ryanforsberg/me507/README.md

# me507
Cal Poly ME 507 Sumo Bot Project

The latest code is located in /Code/Sumo_RTOS/
