ryanforsberg/me507/EAGLE/Schematic/fullboard.brd

## EAGLE design EAGLE/Schematic/fullboard.brd (2019-10-31)

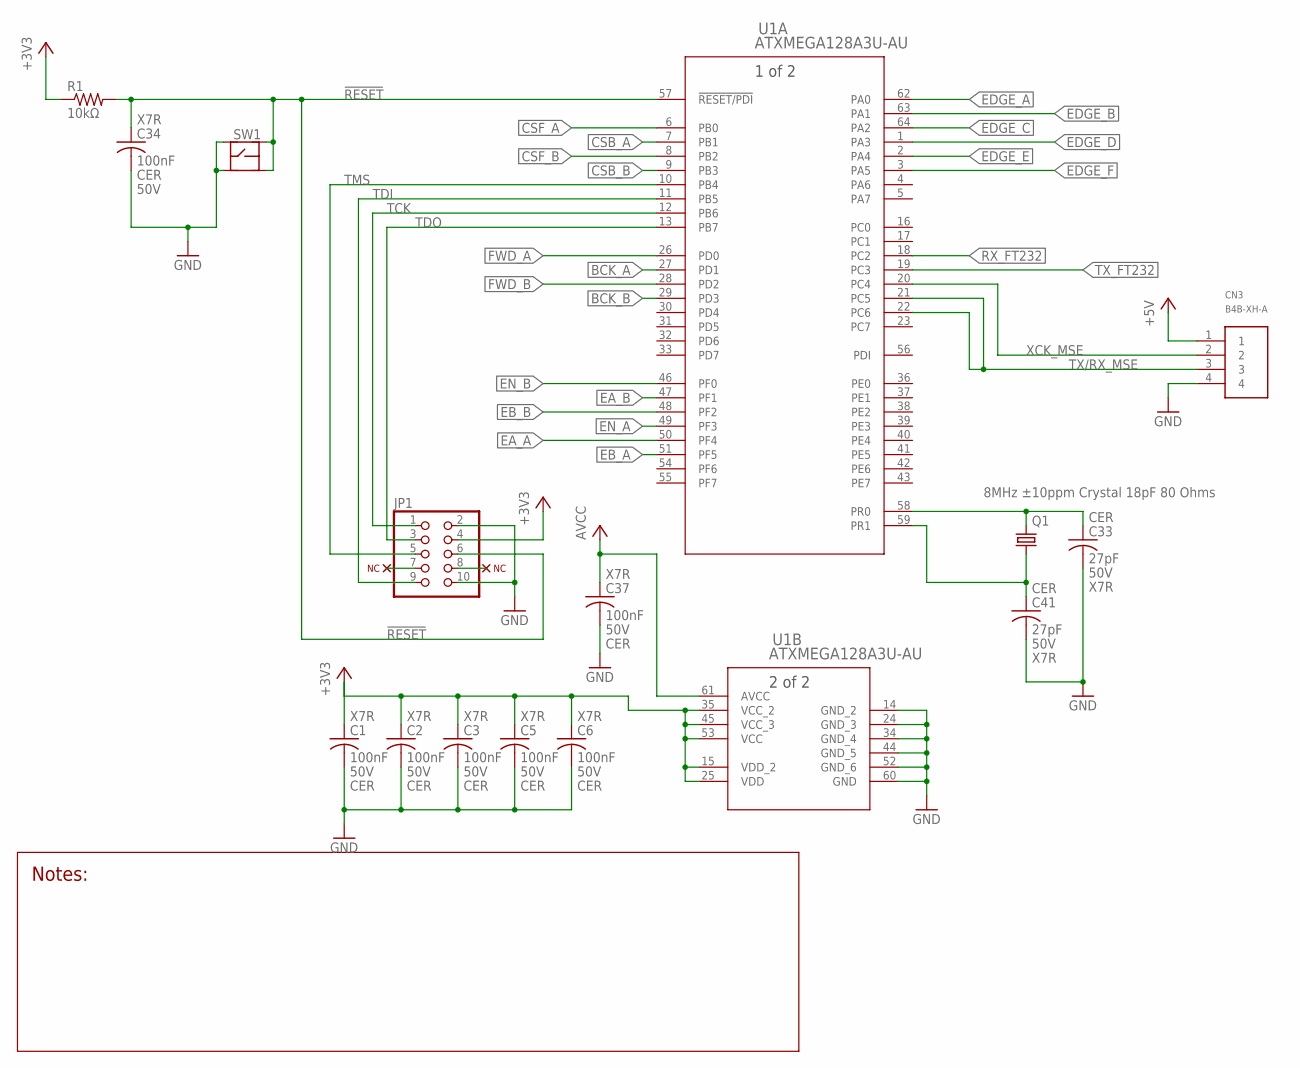
[picture p1: schematic fullboard.sch, sheet 1, MCU]

Parts:
C1, C2, C3, C5, C6, C34, C37: 100nF; C0805
C33, C41: 27pF; C0805
CN3: B4B-XH-A
JP1: PINHD-2X5; 2X05
Q1: 8MHz ±10ppm Crystal 18pF 80 Ohms; HC49UP
R1: 10kΩ; R0805
SW1: TR1-SPST; TR1
U1: ATXMEGA128A3U-AU; 64A

Connections:
!RESET: C34.1, JP1.6, R1.2, SW1.3, SW1.4, U1.57 (!RESET/PDI)
+3V3: C1.1, C2.1, C3.1, C5.1, C6.1, JP1.4, R1.1, U1.15 (VDD_2), U1.25 (VDD), U1.35 (VCC_2), U1.45 (VCC_3), U1.53 (VCC); also elsewhere on the board
+5V: CN3.1; also elsewhere on the board
AVCC: C37.1, U1.61 (AVCC); also elsewhere on the board
BCK_A: U1.27 (PD1); also elsewhere on the board
BCK_B: U1.29 (PD3); also elsewhere on the board
CSB_A: U1.7 (PB1)
CSB_B: U1.9 (PB3)
CSF_A: U1.6 (PB0)
CSF_B: U1.8 (PB2)
EA_A: U1.50 (PF4); also elsewhere on the board
EA_B: U1.47 (PF1); also elsewhere on the board
EB_A: U1.51 (PF5); also elsewhere on the board
EB_B: U1.48 (PF2); also elsewhere on the board
EDGE_A: U1.62 (PA0)
EDGE_B: U1.63 (PA1)
EDGE_C: U1.64 (PA2)
EDGE_D: U1.1 (PA3)
EDGE_E: U1.2 (PA4)
EDGE_F: U1.3 (PA5)
EN_A: U1.49 (PF3); also elsewhere on the board
EN_B: U1.46 (PF0); also elsewhere on the board
FWD_A: U1.26 (PD0); also elsewhere on the board
FWD_B: U1.28 (PD2); also elsewhere on the board
GND: C1.2, C2.2, C3.2, C5.2, C6.2, C33.2, C34.2, C37.2, C41.2, CN3.4, JP1.2, JP1.10, SW1.1, SW1.2, U1.14 (GND_2), U1.24 (GND_3), U1.34 (GND_4), U1.44 (GND_5), U1.52 (GND_6), U1.60 (GND); also elsewhere on the board
RX_FT232: U1.18 (PC2); also elsewhere on the board
TCK: JP1.1, U1.12 (PB6)
TDI: JP1.9, U1.11 (PB5)
TDO: JP1.3, U1.13 (PB7)
TMS: JP1.5, U1.10 (PB4)
TX/RX_MSE: CN3.3, U1.21 (PC5), U1.22 (PC6)
TX_FT232: U1.19 (PC3); also elsewhere on the board
XCK_MSE: CN3.2, U1.20 (PC4)
XTAL1: C41.1, Q1.2, U1.59 (PR1)
XTAL2: C33.1, Q1.1, U1.58 (PR0)

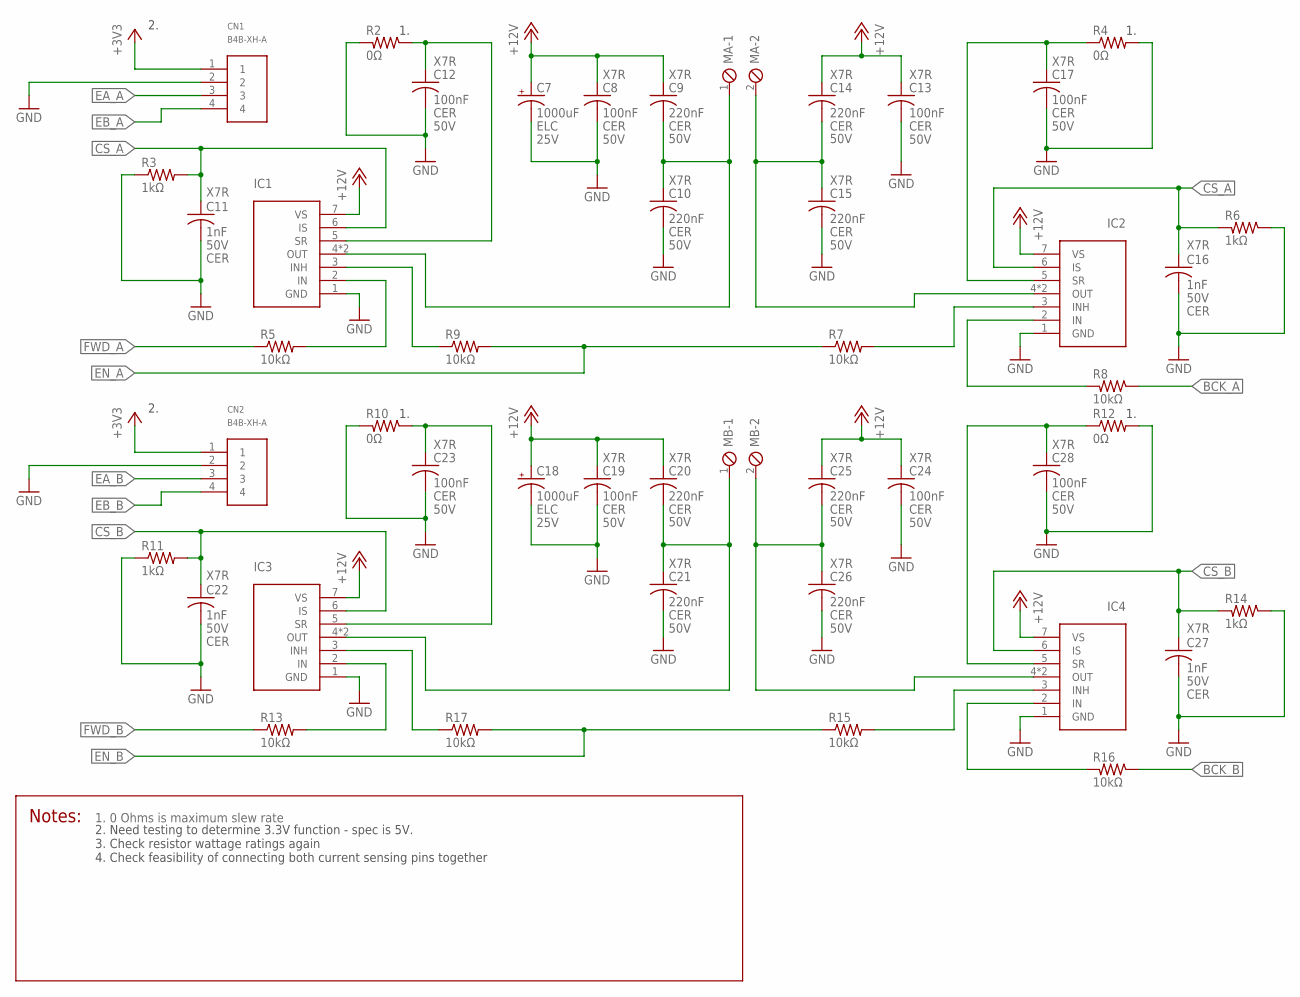
[picture p2: schematic fullboard.sch, sheet 2, Motor drivers]

Parts:
C7, C18: 1000uF; E5-10
C8, C12, C13, C17, C19, C23, C24, C28: 100nF; C0805
C9, C10, C14, C15, C20, C21, C25, C26: 220nF; C0805
C11, C16, C22, C27: 1nF; C0805
CN1, CN2: B4B-XH-A
IC1, IC2, IC3, IC4: IFX007T; TO127P1500X440-7N
MA: SCREWTERM_2P_508; 2POL508
MB: SCREWTERM_2P_508; 2POL508
R2, R4, R10, R12: 0Ω; R0805
R3, R6, R11, R14: 1kΩ; R0805
R5, R7, R8, R9, R13, R15, R16, R17: 10kΩ; R0805

Connections:
+3V3: CN1.1, CN2.1; also elsewhere on the board
+12V: C7.+, C8.1, C9.1, C13.1, C14.1, C18.+, C19.1, C20.1, C24.1, C25.1, IC1.7 (VS), IC2.7 (VS), IC3.7 (VS), IC4.7 (VS); also elsewhere on the board
BCK_A: R8.1; also elsewhere on the board
BCK_B: R16.1; also elsewhere on the board
CS_A: C11.1, C16.1, IC1.6 (IS), IC2.6 (IS), R3.2, R6.2
CS_B: C22.1, C27.1, IC3.6 (IS), IC4.6 (IS), R11.2, R14.2
EA_A: CN1.3; also elsewhere on the board
EA_B: CN2.3; also elsewhere on the board
EB_A: CN1.4; also elsewhere on the board
EB_B: CN2.4; also elsewhere on the board
EN_A: R7.1, R9.2; also elsewhere on the board
EN_B: R15.1, R17.2; also elsewhere on the board
FWD_A: R5.1; also elsewhere on the board
FWD_B: R13.1; also elsewhere on the board
GND: C7.-, C8.2, C10.2, C11.2, C12.2, C13.2, C15.2, C16.2, C17.2, C18.-, C19.2, C21.2, C22.2, C23.2, C24.2, C26.2, C27.2, C28.2, CN1.2, CN2.2, IC1.1 (GND), IC2.1 (GND), IC3.1 (GND), IC4.1 (GND), R2.2, R3.1, R4.2, R6.1, R10.2, R11.1, R12.2, R14.1; also elsewhere on the board
MA_1: C9.2, C10.1, IC1.4 (OUT), IC1.8 (OUT), MA.1
MA_2: C14.2, C15.1, IC2.4 (OUT), IC2.8 (OUT), MA.2
MB_1: C20.2, C21.1, IC3.4 (OUT), IC3.8 (OUT), MB.1
MB_2: C25.2, C26.1, IC4.4 (OUT), IC4.8 (OUT), MB.2
unnamed: C12.1, IC1.5 (SR), R2.1
unnamed: IC2.3 (INH), R7.2
unnamed: IC2.2 (IN), R8.2
unnamed: C17.1, IC2.5 (SR), R4.1
unnamed: IC1.2 (IN), R5.2
unnamed: C23.1, IC3.5 (SR), R10.1
unnamed: IC4.2 (IN), R16.2
unnamed: IC4.3 (INH), R15.2
unnamed: C28.1, IC4.5 (SR), R12.1
unnamed: IC3.3 (INH), R17.1
unnamed: IC3.2 (IN), R13.2
unnamed: IC1.3 (INH), R9.1

Notes on the sheet:
2. Need testing to determine 3.3V function - spec is 5V. 3. Check resistor wattage ratings again 4. Check feasibility of connecting both current sensing pins together

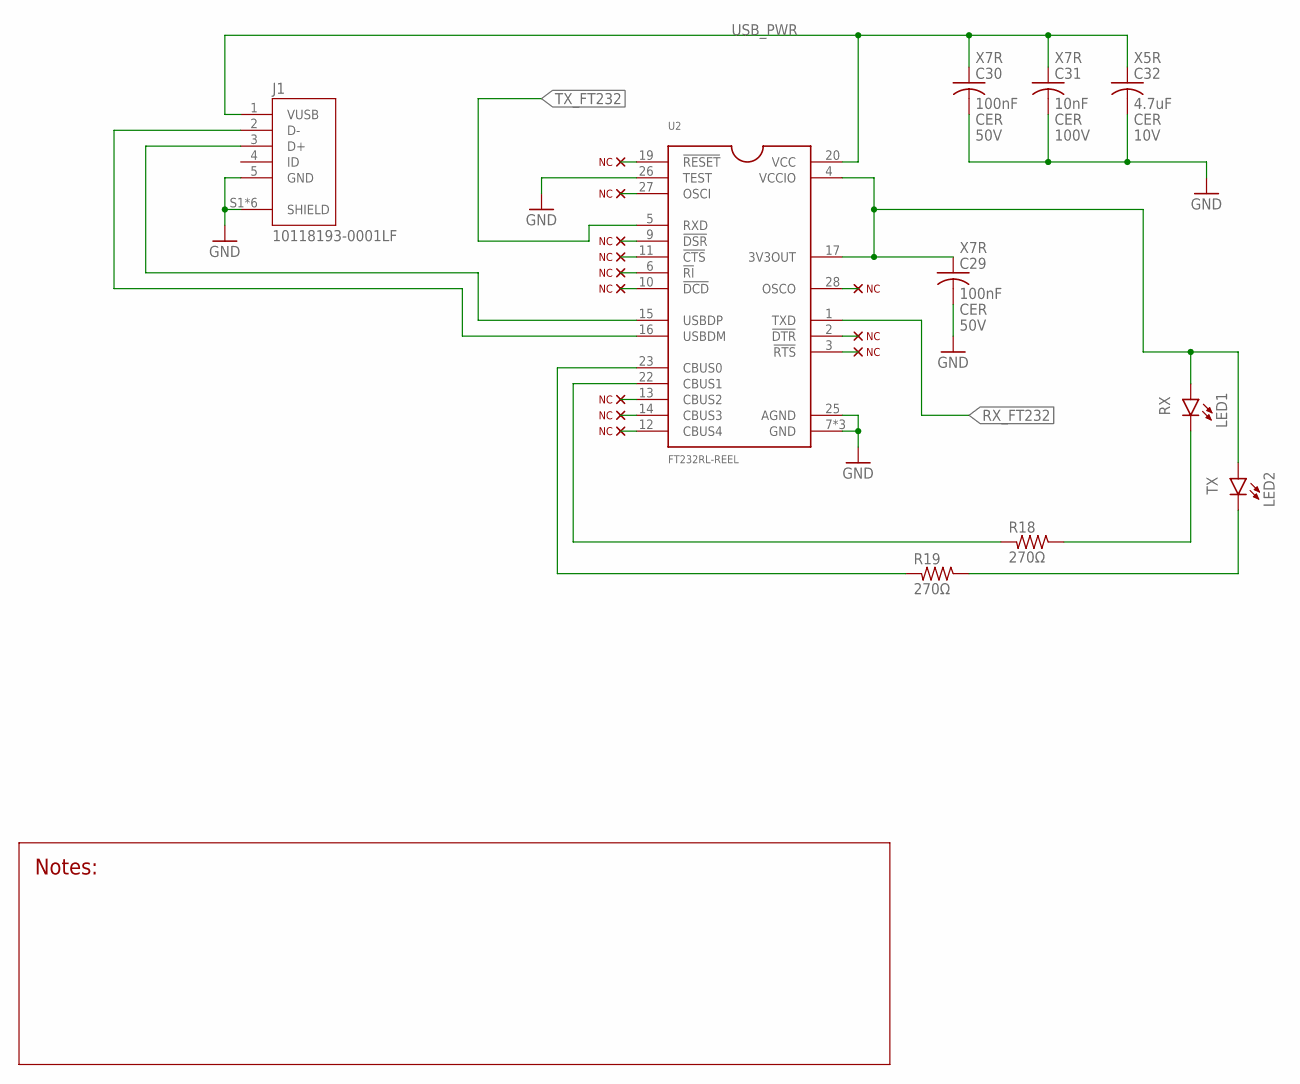
[picture p3: schematic fullboard.sch, sheet 3, USB/UART]

Parts:
C29, C30: 100nF; C0805
C31: 10nF; C0805
C32: 4.7uF; C0805
J1: 10118193-0001LF; FCI_10118193-0001LF
LED1, LED2: LEDSML0805; SML0805
R18, R19: 270Ω; R0805
U2: FT232RL-REEL; SOP65P780X200-28N

Connections:
GND: C29.2, C30.2, C31.2, C32.2, J1.5 (GND), J1.S1 (SHIELD), J1.S2 (SHIELD), J1.S3 (SHIELD), J1.S4 (SHIELD), J1.S5 (SHIELD), J1.S6 (SHIELD), U2.7 (GND), U2.18 (GND), U2.21 (GND), U2.25 (AGND), U2.26 (TEST); also elsewhere on the board
unnamed: J1.2 (D-), U2.16 (USBDM)
unnamed: J1.3 (D+), U2.15 (USBDP)
unnamed: LED2.C, R19.1
unnamed: R19.2, U2.23 (CBUS0)
unnamed: R18.2, U2.22 (CBUS1)
unnamed: LED1.C, R18.1
RX_FT232: U2.1 (TXD); also elsewhere on the board
TX_FT232: U2.5 (RXD); also elsewhere on the board
USB_PWR: C30.1, C31.1, C32.1, J1.1 (VUSB), U2.20 (VCC)
VCCIO: C29.1, LED1.A, LED2.A, U2.4 (VCCIO), U2.17 (3V3OUT)

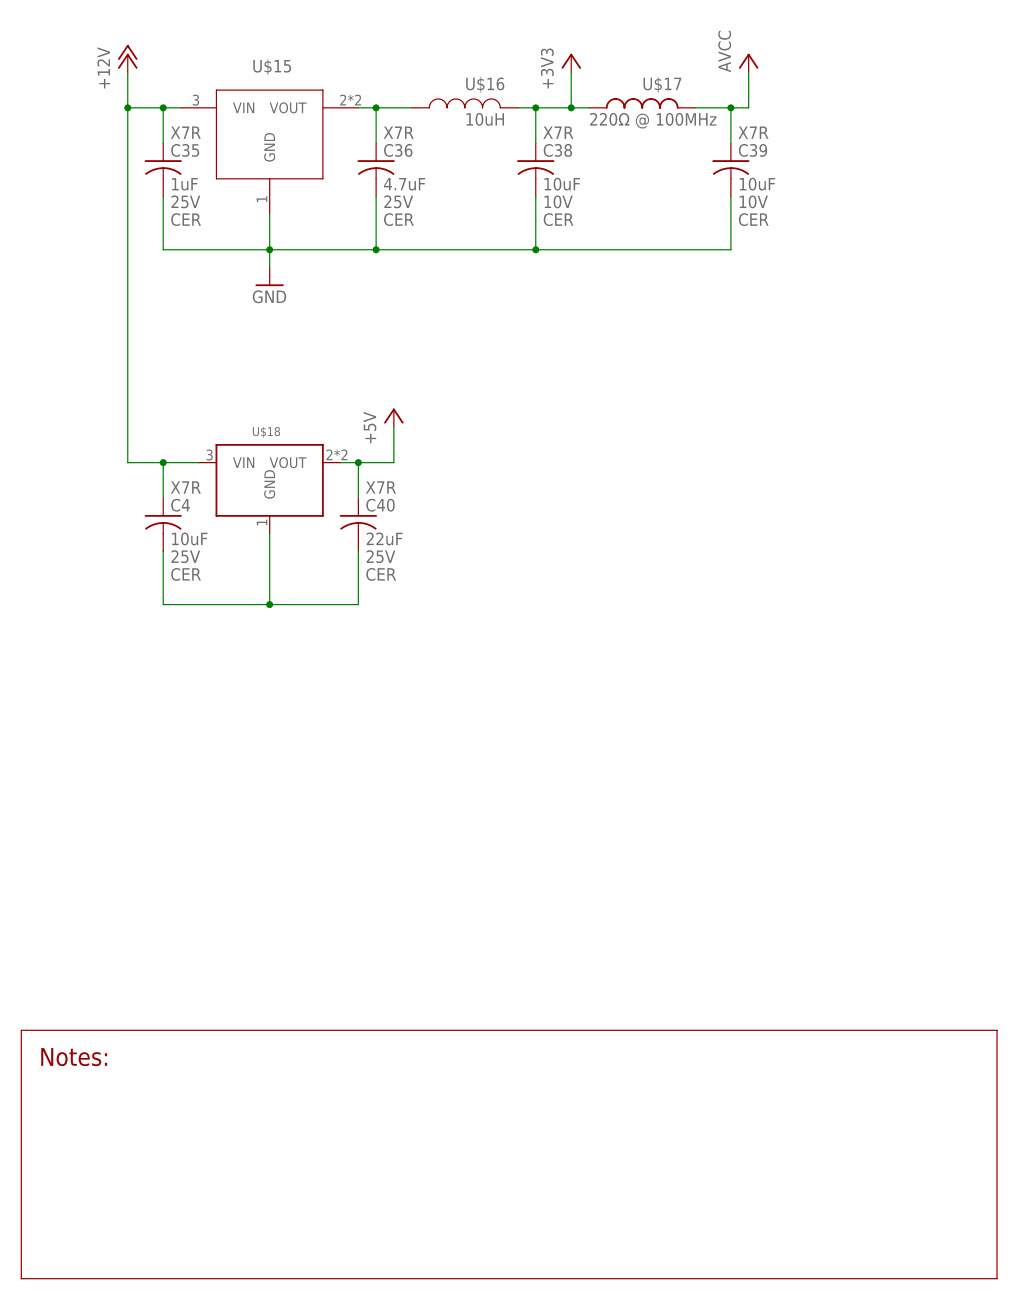
[picture p4: schematic fullboard.sch, sheet 4, Power]

Parts:
C4, C38, C39: 10uF; C1206
C35: 1uF; C0805
C36: 4.7uF; C1206
C40: 22uF; C1210
U$15: LDL1117S33R; SOT230P700X190-4N
U$16: RLB0914-100KL; INDRD580W65D870H1300B; RATING 10uH
U$17: BLM21PG221SN1D; C0805; RATING 220Ω @ 100MHz
U$18: AZ1117IH; SOT223

Connections:
+3V3: C38.1, U$16.1, U$17.1; also elsewhere on the board
+5V: C40.1, U$18.2 (VOUT), U$18.4 (VOUT); also elsewhere on the board
+12V: C4.1, C35.1, U$15.3 (VIN), U$18.3 (VIN); also elsewhere on the board
AVCC: C39.1, U$17.2; also elsewhere on the board
GND: C35.2, C36.2, C38.2, C39.2, U$15.1 (GND); also elsewhere on the board
unnamed: C4.2, C40.2, U$18.1 (GND)
unnamed: C36.1, U$15.2 (VOUT), U$15.4 (VOUT), U$16.2

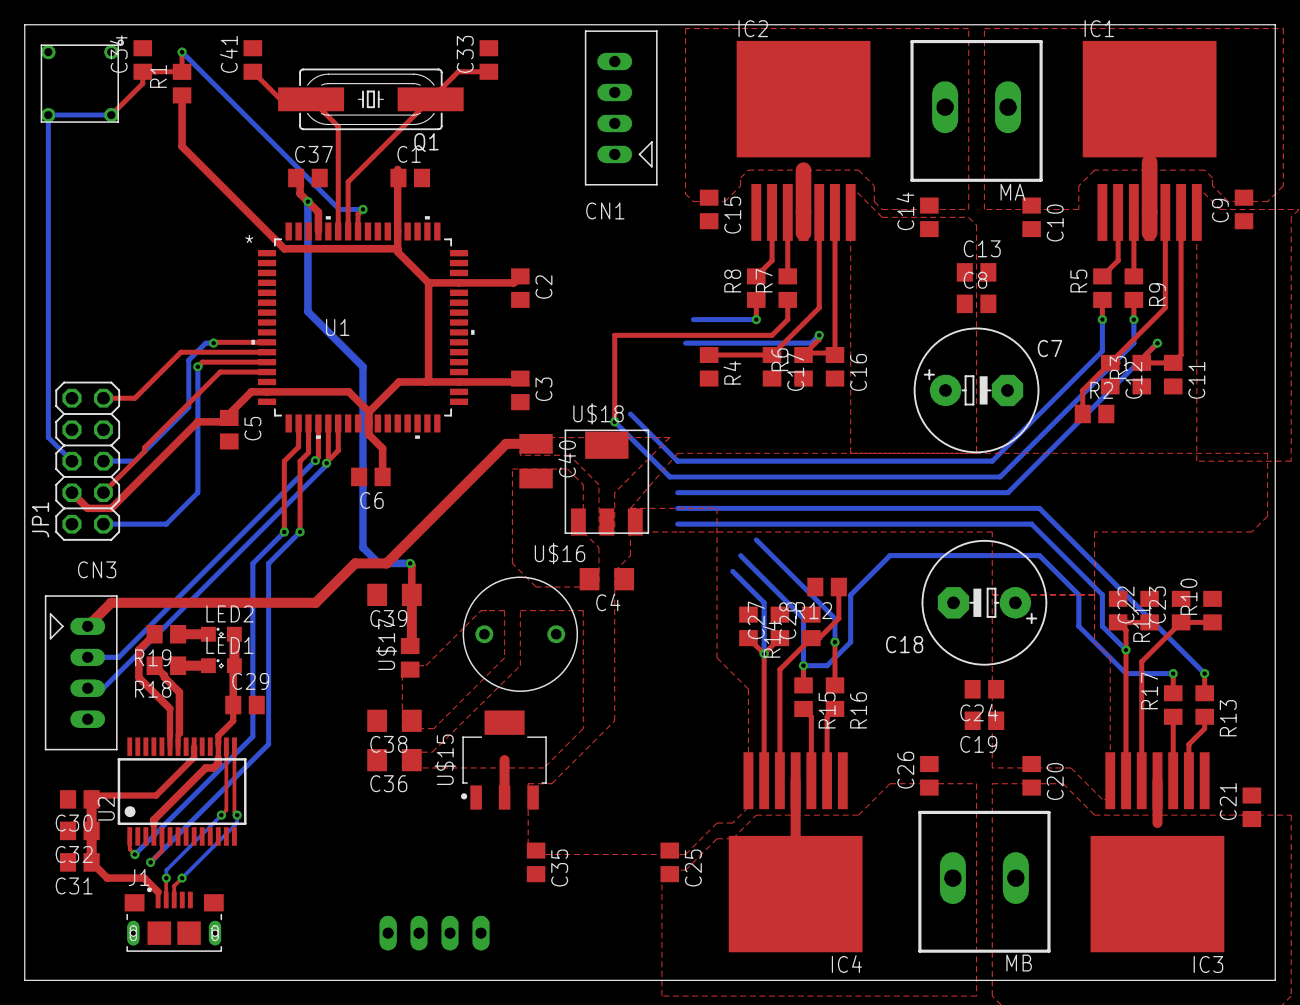
[picture p5: board fullboard.brd from above]

Board: 2 copper layers, 100.9 x 77.1 mm, 81 parts (1 on the bottom side), 54 nets.
