ryanforsberg/me507/(commit log)

2019-10-25 LED Blink
    Day one of dev board testing with opponent detection
2019-10-25 LED Blink - Frequency change
2019-10-27 Software Downloads for Driver and Bootloader
2019-10-27 Changes to main.cpp
    First attempt at pulsed PWM of the IR LED - not tested
2019-10-31 Power and Clock schematics
    [SumoBot.sch]
2019-10-31 V0.0 of the board
    Missing:
    * Headers/Connectors for edge sensors
    * Any potential for mouse use (5V regulator system needed)
    * Opponent painting potential
    * Breakout of extra pins
    Other todos:
    * Confirm pad sizes with Charlie, probably need to be redone for sufficient room for solder... (_great_).
    * ???
    * Profit
    [fullboard.brd, fullboard.sch]
2019-10-31 Added libraries
    Added the libraries I've been using - some of the footprints definitely need to be looked at before we order.
2019-10-31 V0.1 of the board
    Did some more signal routing, added a connector for the mouse, added a simple 5V regulator circuit
    Still need:
    * Edge sensor connectors
    * Footprint 2x check
    * Probably some other things
    [fullboard.brd, fullboard.sch]
2019-10-31 Updated to reflect V0.1 of the board
2019-10-31 V0.2
    Added Edge Detection and reconfigured other pins
    [fullboard.brd, fullboard.sch]
2019-11-01 V0.3
    Don't you dare put a fucking fuse holder on the board.
    Added:
    * Routing all the remaining signals
    * Vias for breakout of leftover pins
    * Now with 200% more suffering
    Still to do:
    * Things
    [fullboard.brd, fullboard.sch]
2019-11-01 V0.4
    Added vias as test points for the two USART channels
    [fullboard.brd]
2019-11-02 v0.5
    Changes/Status
    * Silkscreen - done, do a final check after walking away for a bit
    * Mounting - #4 screws - moved the ones I could the way I could
    * AREF - should be ok, made vias for use of jumpering if needed.
    Todo:
    * Final check by Charlie
    * ...
    * profit
    [fullboard.brd, fullboard.sch]
2019-11-05 Create Encoders.txt
    First attempt at encoder setup for Port D, event channel 0, timer channel 0
2019-11-06 v0.6
    Changes
    * Adjusted part locations for increased fastener backup
    * Added text label
    [fullboard.brd]
2019-11-07 v0.7
    * Create solderable vias for +3.3V and +5V
    * Add labels for those vias
    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
    [fullboard.brd]
2019-11-07 Delete SumoBot.sch
    No longer needed
    [SumoBot.sch]
2019-11-07 v0.8
    Fixed the USB connector footprint
    [fullboard.brd, fullboard.sch]
2019-11-08 v0.9
    * Final board used for Fab
    [fullboard.brd, fullboard.sch]
2019-11-08 Creating Gerber folder
    [copper_bottom.gbr]
2019-11-08 Uploaded gerber files
    [copper_bottom.gbr, copper_top.gbr, drill_1_16.xln, gerber_job.gbrjob, profile.gbr, silkscreen_bottom.gbr, silkscreen_top.gbr, soldermask_bottom.gbr]
2019-11-15 Creation of ADC and Edge Sensor Task Project
    Initial ADCA Set Up in progress
2019-11-18 Main Software Folder
    Working on ADC read function
2019-11-19 Continued ADC Reading development
2019-12-03 Added shares.h, motor driver, and location tasks
2019-12-03 Motor Driver communications truth table - also, deleted fucking.
    * Truth Table:
    * Inputs Direction Outputs
    * FWD BCK LFT RHT FWD_A BCK_A FWD_B BCK_B
    * 1 0 0 0 Forward 1 0 1 0
    * 0 1 0 0 Backward 0 1 0 1
    * 0 0 1 0 Pivot Left 0 1 1 0
    * 0 0 0 1 Pivot Right 1 0 0 1
    * 1 0 1 0 Left Forward Turn 0 0 1 0
    * 1 0 0 1 Right Forward Turn 1 0 0 0
    * 0 1 1 0 Left Backward Turn 0 0 0 1
    * 0 1 0 1 Right Backward Turn 0 1 0 0
2019-12-05 Edge detecting, Motor driver progressing 5pm
2019-12-05 Fixed major bug w/ Motor Drivers
    [main.cpp, task_Motor.cpp]
2019-12-05 Another major bugfix
    I believe the compiler was over-optimizing. It would never enter the test mastermind task.
    Have not tested the latest iteration (waiting on programmer), but previously was able to switch between forward and back via intra-task communication.
    [main.cpp, task_Motor.cpp, task_Motor.h, task_mastermind.cpp, task_mastermind.h]
2019-12-05 Late night complete
    Edge detection through mastermind to motor drivers active. Still need to test thoroughly
2019-12-05 Late night complete
    edge to mastermind to motor connection
2019-12-10 V1.0
    Final version board design
    [fullboard.brd, fullboard.sch]
